SiraajBedford/Analogue-Power-Meter/README.md

# power meter

Machine
