SiraajBedford/Analogue-Power-Meter/Reports/Report 1/App-A.tex

     \chapter{Appendix A: Social contract}
     \vspace{-15mm}
     \begin{figure}[!htb]
     \centering
     	\fbox{}
       \label{fig:social_contract}
	\end{figure}
