SiraajBedford/Analogue-Power-Meter/Reports/Report 1/App-B.tex

     %\chapter{Appendix B: Wiring safety check}
    % \vspace{-15mm}
   %  \begin{figure}[!htb]
  %   \centering
 %    	\fbox{\includegraphics[width=0.75\linewidth]{./Figures/SafetyCheck.pdf}}
%	\label{fig:plugSafety}
%	\end{figure}

	     \chapter{Appendix B: Plug Safety Check}
     \vspace{-15mm}
     \begin{figure}[!htb]
     \centering
     	\fbox{}
       \label{fig:}
	\end{figure}
