SiraajBedford/Analogue-Power-Meter/Reports/Report 1/App-C.tex

 	     \chapter{Appendix C: GitHub Screengrab}
     \vspace{-15mm}
     \begin{figure}[!htb]
     \centering
     	\fbox{}
       \label{fig:}
	\end{figure}
