SiraajBedford/Analogue-Power-Meter/Reports/Report 1/Chapter6.tex

\chapter{System test results}

\begin{figure}[h]
    \centering
    
    \caption{Final system diagram}
    \label{fig:Final}
\end{figure}

The diagram in \ref{fig:Final} shows the complete system diagram for this stage of the power meter project.
The following outputs are available

\begin{itemize}
    \item The 12 V output from the switchmode regulator
    \item The +5 V output from the 5 V regulator
    \item The -5 V output from the charge pump scheme
\end{itemize}
