SiraajBedford/Analogue-Power-Meter/Reports/Report 2/App-A.tex

     \chapter{Appendix A: GitHub Activity Heatmap}

     \begin{figure}[H]
     \centering
     	\fbox{}
	\label{fig:github}
	\end{figure}
