SiraajBedford/Analogue-Power-Meter/Reports/Report 2/App-B.tex

     \chapter{Appendix B: Simulation Figures} 

\begin{figure}[H]
    \centering
    
    \caption{Nominal input and output with 1 volt change for $t>0.5s$}
    \label{fig:nomial_voltages}
\end{figure}

\begin{figure}[H]
    \centering
    
     \caption{Nominal input and output with 10 mA change for $t>0.5s$}
    \label{fig:nominal_current}
\end{figure}

\begin{figure}[H]
  \centering
  
    \caption{XOR AC output and Phase transducer output for a load impedance \\$Z=1000+j \cdot \omega \cdot 22\mu \  \Omega$ }
    \label{fig:phase22u}
\end{figure}

 \begin{figure}[H]
  \centering
  
    \caption{XOR AC output and Phase transducer output for a load impedance \\$Z=1000+j \cdot \omega \cdot 33\mu \  \Omega$ }
    \label{fig:phase33u}
\end{figure}
