SiraajBedford/Analogue-Power-Meter/Reports/Report 2/App-C.tex

\chapter{Appendix C: System Diagram}

\begin{figure}[H]
    \centering
   \fbox{} 
    \caption{System Diagram showing power supplies and op-amps used}
    \label{fig:system_diagram}
\end{figure}
