SiraajBedford/Analogue-Power-Meter/Reports/Report 2/App-D.tex

\chapter{Appendix D: System Test Diagrams}

\begin{figure}[H]
    \centering
    
    \caption{Switching noise on -5 VDC supply of charge pump output }
    \label{fig:-5V_noise}
\end{figure}

\begin{figure}[H]
    \centering
    
    \caption{Noise on LM7805 +5 VDC supply}
    \label{fig:+5V_noise}
\end{figure}

\begin{figure}[H]
    \centering
    
    \caption{Current consumption voltages on channel 1 and 2 for a bulky 100 $\Omega$ resistive load}
    \label{fig:system_current}
\end{figure}
