SiraajBedford/Analogue-Power-Meter/Reports/Report 3/App-A.tex

     \chapter{Appendix A: GitHub Activity Heatmap}

     \begin{figure}[!htb]
     \centering
     	\fbox{}
	\label{fig:github}
	\end{figure}
