SiraajBedford/Analogue-Power-Meter/Reports/Report 3/declaration.tex

\chapter{Declaration}

By submitting this report electronically, I declare that the entirety of the work contained
therein is my own, original work, that I am the sole author thereof (save to the extent
explicitly otherwise stated), that reproduction and publication thereof by Stellenbosch
University will not infringe any third party rights and that I have not previously in its
entirety or in part submitted it for obtaining any qualification.

\vspace{3cm}
\hspace{1.5cm}
\vspace{-.8cm}
\\
\noindent%
\parbox{.5\textwidth}{%
  Signature:\quad\dotfill\par
  \hfill S.\ Bedford\hspace{1.2cm}\null}

\vspace{1.5cm}
\hspace{2.7cm}
\vspace{-.5cm}
\\
\noindent%
\parbox{.5\textwidth}{%
  Date:\quad\dotfill\par}
