SiraajBedford/Analogue-Power-Meter/Reports/Report 1/nomenclature.tex

\chapter{Nomenclature}

\begin{Nomencl}
 \NomGroup{Constants}%-----------------------------------------------
   \item[$\mathrm{g} = $] $\mathrm{9.81\,m/s^2}$

 \NomGroup{Variables}%-----------------------------------------------
   \item[$P$]
                      \UnitLine{Power}{W}

\end{Nomencl}

\endinput
