SiraajBedford/Analogue-Power-Meter/Reports/Report 2/nomenclature.tex

\chapter{Nomenclature}

\begin{Nomencl}

 \NomGroup{List Of Constants}%-----------------------------------------------
  \item[$V_T=26$]
                   \UnitLine{Thermal Voltage}{mV}
 \NomGroup{List Of Variables}%-----------------------------------------------

   \item[$V_{pp}$]
                      \UnitLine{Peak-to-peak Voltage}{V_{p-p}}
   \item[$V_{peak}$]
                      \UnitLine{Peak Voltage}{V_{peak}}
   \item[$\tau$]
                      \UnitLine{Time Constant}{s}
   \item[$Z$]
                      \UnitLine{Impedance}{\Omega}

    \NomGroup{List of Abbreviations}
   \item[AC]        Alternating Current
   \item[DC]        Direct Current
   \item[RMS]      Root Mean Square  
   \item[op-amp] Operational Amplifier
   \item[ADC] Analog-to-Digital Converter
   \item[pp] peak-to-peak   
   \item[p] peak   
   \item[KVL] Kirchoff's Voltage Law
     \item[KCL] Kirchoff's Current Law
    \item[LPF] Low Pass Filter
    \item[XOR] Exclusive OR gate
    \item[PWM] Pulse Width Modulated
    
    \NomGroup{List of Units}
   \item[F] Farad
   \item[$\Omega$] Ohm
    \item[\si{\ampere}] Ampere
    \item[\si{\volt}] Volt

\end{Nomencl}

\endinput
