SiraajBedford/Analogue-Power-Meter/LTSpice/Demo 2/Voltage Peak detector/VarDesigns.asc

C1: cap; 100n
C2: cap; 100n
C3: cap; 100n
C4: cap; 100n
D1: diode; 1N4007
D2: diode; 1N4007
D3: diode; 1N4007
D4: diode; 1N4007
D5: diode; 1N4007
D6: diode; 1N4007
R1: res; 20k
R2: res
U1: opamp2; TLC2272
U2: opamp2; TLC2272
U3: opamp2; TLC2272
U4: opamp2; TLC2272
U5: opamp2; TLC2272
U6: opamp2; TLC2272
U7: opamp2; TLC2272
Named nets: 0, +5V_LM7805
