SiraajBedford/Analogue-Power-Meter/LTSpice/Demo 3/Switch with overcurrent protection/V_Designs.asc

U1: opamp2; TL081
U2: opamp2; TL081
V1: voltage; 1.4
Named nets: +5V_78, 0
