SiraajBedford/Analogue-Power-Meter/LTSpice/Final/21093741.asc

C2: cap; 150µ
C3: cap; 122µ
C4: cap; 122µ
C5: cap; 0.33µ
C6: cap; 0.1µ
C7: cap; 10µ
C8: cap; 100µ
C16: cap; 1n
C17: cap; 100n
C18: cap; 30µ
Cff1: cap; 3.7n
D3: diode
D4: schottky; 1N5822
D5: diode; 1N4148
D6: diode; 1N4148
D7: zener; 1N750
D13: diode; 1N4148
D14: diode; 1N4148
D15: diode; 1N4148
D16: diode; 1N4148
L1: ind; 68µ
LOAD2: res; 100
Q4: npn; 2N3904
Q5: npn; 2N3904
Q6: npn; 2N3904
Q7: npn; 2N3904
Q8: npn; 2N3904
Q9: npn; 2N3904
R15: res; 1k
R16: res; 8.2k
R17: res; 1k
R18: res; 1k
R19: res; 1k
R20: res; 3.9k
R21: res; 33
R22: res; 100k
R23: res; 100k
R24: res; 1.5Meg
R25: res; 100k
R26: res; 10k
R27: res; 10k
R28: res; 1k
R29: res; 1k
R30: res; 10k
R31: res; 10k
R32: res; 1k
R33: res; 1.2k
R34: res; 150k
R35: res; 1k
R36: res; 2.2k
R37: res; 1k
R38: res; 20k
R39: res; 7000
R40: res; 10k
R41: res; 5.8
R_Sense2: res; 30m
U8: LM2595_ADJ_TRANS
U9: LM7805
U10: opamp2; TLC2272
U11: MOC3020
U12: opamp2; TLC2272
U13: opamp2; TLC2272
U14: opamp2; TLC2272
U15: opamp2; TLC2272
U16: opamp2; TLC2272
U17: opamp2; TLC2272
U18: opamp2; TLC2272
U19: XOR_2
U20: opamp2; TLC2272
U21: opamp2; TLC2272
U22: opamp2; TLC2272
V2: voltage; PULSE(0 5 0 0 0 50u 100u)
V8: voltage; 0
V9: voltage; 0
V10: voltage; -5
V11: voltage; 5
V12: voltage; 5
V13: voltage; 3
V14: voltage; PULSE(0 5 0 0 0 1 2)
V_source_RMS1: voltage; SINE(0 30.8 50)
Named nets: 0, -5V_charge_pump, +12V_switchmode, +5V_LM7805, Rectifier_Ouput, +5V_78, -5V_CP, XOR_out, XOR_in1, XOR_in2, V_mains, V_mains_TRIAC_result, V_LED_+, S, Current_REF
.inc MOC302x.lib
.inc BT134.lib
.inc 2N3904.lib
.tran 0 2 0 1
.inc TL081.lib
.inc TLC2272.lib
.inc LM78XX_RS.lib
.inc XOR_2.asy
.inc DigitalLogic.lib
.inc 1N400.lib
.inc ST_POWER_SCHOTTKY_V6.LIB
