SiraajBedford/Analogue-Power-Meter/LTSpice/Demo 1/Charge pump/ChargeP.asc

C1: cap; 10µ
C2: cap; 100µ
D1: diode; 1N4148
D2: diode; 1N4148
D3: zener; 1N750
Q1: npn; 2N3904
Q2: npn; 2N3904
Q3: npn; 2N3904
R1: res; 1k
R2: res; 1k
R3: res; 1k
R4: res; 3.9k
R5: res; 33
V1: voltage; PULSE(0 5 0 0 0 50u 100u)
V2: voltage; 12
Named nets: 0, -5V
.inc 2N3904.lib
.tran 0 70m 0 0.1
50% duty cycle from arduino PWM
12V From switchmode regulator
