SiraajBedford/Analogue-Power-Meter/LTSpice/Demo 1/Combination of Sub circuits/Final.asc

C1: cap; 0.33µ
C2: cap; 0.1µ
C3: cap; 10µ
C4: cap; 100µ
C5: cap; 150µ
C6: cap; 122µ
C7: cap; 122µ
Cff: cap; 3.7n
D1: diode; 1N4148
D2: diode; 1N4148
D3: diode
D4: schottky; 1N5822
D5: zener; 1N750
L1: ind; 68µ
Q1: npn; 2N3904
Q2: npn; 2N3904
Q3: npn; 2N3904
R1: res; 1k
R2: res; 1k
R3: res; 1k
R4: res; 1k
R5: res; 8.2k
R6: res; 3.9k
R8: res; 33
U1: LM7805
U2: LM2595_ADJ_TRANS
V1: voltage; PULSE(0 5 0 0 0 50u 100u)
V2: voltage; 0
V3: voltage; 0
V_source_RMS1: voltage; SINE(0 30.8 50)
Named nets: 0, -5V_charge_pump, +12V_switchmode, +5V_LM7805, Rectifier_Ouput
.tran 0 0.5 0 0.1
.inc LM2595_ADJ_TRANS.LIB
.inc ST_POWER_SCHOTTKY_V6.LIB
.inc 2N3904.lib
.inc LM78XX_RS.lib
