SiraajBedford/Analogue-Power-Meter/LTSpice/Demo 1/Combination of Sub circuits/Rep3.asc

C1: cap; 10µ
C2: cap; 100µ
C3: cap; 0.33µ
C4: cap; 0.1µ
C5: cap; 150µ
C6: cap; 122µ
C7: cap; 122µ
Cff1: cap; 3.3n
D1: diode; 1N4148
D2: diode; 1N4148
D3: zener; 1N750
D4: diode
D5: schottky; 1N5822
L1: ind; 68µ
Q1: npn; 2N3904
Q2: npn; 2N3904
Q3: npn; 2N3904
R1: res; 1k
R2: res; 1k
R3: res; 1k
R4: res; 3.9k
R5: res; 33
R6: res; 100
R7: res; 1k
R8: res; 8.2k
U1: LM7805
U2: LM2595_ADJ_TRANS
V1: voltage; PULSE(0 5 0 0 0 50u 100u)
V2: voltage; 12
V3: voltage; 12
V_peak1: voltage; SINE(0 22.4 50)
Named nets: 0, -5V, V_out, 12V
.inc 2N3904.lib
50% duty cycle from arduino PWM
12V From switchmode regulator
.inc LM78XX_RS.lib
.inc LM2595_ADJ_TRANS.LIB
.inc ST_POWER_SCHOTTKY_V6.LIB
.tran 0 1 0 1
