SiraajBedford/Analogue-Power-Meter/LTSpice/Demo 1/Linear/linear.asc

C1: cap; 0.33µ
C2: cap; 0.1µ
R1: res; 100
U2: LM7805
V1: voltage; 12
Named nets: 0, V_out
.inc LM78XX_RS.lib
.tran 0 1 0 0.1
