SiraajBedford/Analogue-Power-Meter/LTSpice/Demo 1/Rectifier/rectifier.asc

C1: cap; 150µ
D1: diode
R1: res; 100
V_peak: voltage; SINE(0 30.8 50)
Named nets: 0, V_out
.tran 0 0.15 0 1
