SiraajBedford/Analogue-Power-Meter/LTSpice/Demo 1/Switchmode/Switchmode.asc

C1: cap; 122µ
C3: cap; 122µ
Cff: cap; 3.3n
D2: schottky; 1N5822
L1: ind; 68µ
R1: res; 1k
R2: res; 8.2k
U1: LM2595_ADJ_TRANS
Vpp: voltage; 32
Named nets: 0, 12V
.inc LM2595_ADJ_TRANS.LIB
.inc ST_POWER_SCHOTTKY_V6.LIB
.tran 0 10m 0 1
