SiraajBedford/Analogue-Power-Meter/LTSpice/Demo 2/Current Peak detector/CurrentSensing.asc

C2: cap; 100n
D1: diode; 1N4148
D3: diode; 1N4148
I1: current; PWL(0 0 0.5 0 0.51 10m 1 10m)
LOAD: res; 154
R1: res; 20k
R2: res; 2.2k
R3: res; 150k
R4: res; 1k
R5: res; 1k
R_Sense: res; 30m
U1: opamp2; TLC2272
U2: opamp2; TLC2272
U3: opamp2; TLC2272
U4: opamp2; TLC2272
V1: voltage; -5
V2: voltage; 5
V3: voltage; SINE(0 30.8 50)
Named nets: 0, +5V_78, -5V_CP, Nominal_Output
.inc TL081.lib
.inc TLC2272.LIB
.tran 0 1 0 1
