SiraajBedford/Analogue-Power-Meter/LTSpice/Demo 2/Final Circuit/Demo_2_Final.asc

C1: cap; 0.33µ
C2: cap; 0.1µ
C3: cap; 10µ
C4: cap; 100µ
C5: cap; 150µ
C6: cap; 122µ
C7: cap; 122µ
C8: cap; 1n
C9: cap; 100n
C10: cap; 30µ
Cff: cap; 3.7n
D1: diode; 1N4148
D2: diode; 1N4148
D3: diode
D4: schottky; 1N5822
D5: zener; 1N750
D6: diode; 1N4148
D7: diode; 1N4148
D8: diode; 1N4148
D9: diode; 1N4148
L1: ind; 68µ
LOAD1: res; 100
Q1: npn; 2N3904
Q2: npn; 2N3904
Q3: npn; 2N3904
R1: res; 1k
R2: res; 1k
R3: res; 1k
R4: res; 1k
R5: res; 8.2k
R6: res; 3.9k
R7: res; 150k
R8: res; 33
R9: res; 1k
R10: res; 2.2k
R11: res; 10k
R12: res; 1k
R13: res; 1.2k
R14: res; 1k
R15: res; 20k
R16: res; 7000
R20: res; 1.5Meg
R21: res; 100k
R_Sense1: res; 30m
U1: LM7805
U2: LM2595_ADJ_TRANS
U3: opamp2; TLC2272
U4: opamp2; TLC2272
U5: opamp2; TLC2272
U6: opamp2; TLC2272
U7: opamp2; TLC2272
U8: opamp2; TLC2272
U9: opamp2; TLC2272
U10: XOR_2
U11: opamp2; TLC2272
U12: opamp2; TLC2272
V1: voltage; PULSE(0 5 0 0 0 50u 100u)
V_source_RMS1: voltage; SINE(0 30.8 50)
Named nets: 0, +12V_switchmode, +5V_78, -5V_CP, To_current_peak_detector, XOR_out, XOR_in1, XOR_in2
.tran 0 5 0 5
.inc LM2595_ADJ_TRANS.LIB
.inc ST_POWER_SCHOTTKY_V6.LIB
.inc 2N3904.lib
.inc TL081.lib
.inc TLC2272.LIB
.inc LM78XX_RS.lib
.inc 1N400.lib
.inc DigitalLogic.lib
