SiraajBedford/Analogue-Power-Meter/LTSpice/Demo 2/Phase Shift Detector/PhaseShiftXOR.asc

C1: cap; 55µ
C2: cap; 33µ
D1: diode; 1N4148
D2: diode; 1N4148
LOAD1: res; 1k
R1: res; 6.8k
R2: res; 150k
R3: res; 1k
R4: res; 1k
R5: res; 5.6k
R_Sense1: res; 30m
U1: XOR_2
U2: opamp2; TLC2272
U3: opamp2; TLC2272
U4: opamp2; TLC2272
U5: opamp2; TLC2272
V1: voltage; SINE(0 30.8 50)
V2: voltage; -5
V3: voltage; 5
V4: voltage; SINE(0 2 50 0 0 0)
Named nets: XOR_out, XOR_in1, XOR_in2, 0, +5V_78, -5V_CP, Phase_Shift_Voltage, Voltage_in, Current_in
.inc DigitalLogic.lib
.tran 0 2.5 0 1
.inc TL081.lib
.inc TLC2272.lib
