SiraajBedford/Analogue-Power-Meter/LTSpice/Demo 2/Voltage Peak detector/Voltage shifter and peak detector.asc

C1: cap; 1n
D1: diode; 1N4148
D3: diode; 1N4148
R1: res; 1.5Meg
R2: res; 100k
R3: res; 1k
R4: res; 1.2k
R5: res; 10k
U1: opamp2; TLC2272
U2: opamp2; TLC2272
U3: opamp2; TLC2272
V1: voltage; SINE(0 30.8 50)
V2: voltage; 5
V3: voltage; -5
V4: voltage; PWL(0 0 0.5 0 0.51 1 1 1)
Named nets: 0, +5V_78, -5V_CP, Nominal_Output, Step, Nominal_Input
.inc TL081.lib
.inc TLC2272.LIB
.tran 0 1 0 1
.inc 1N400.lib
