SiraajBedford/Analogue-Power-Meter/LTSpice/Demo 3/Current Sensing with switch/Dems.asc

LOAD1: res; 100
Q1: npn; 2N3904
Q2: npn; 2N3904
Q3: npn; 2N3904
R6: res; 100k
R7: res; 100k
R8: res; 10k
R9: res; 10k
R10: res; 1k
R11: res; 1k
R12: res; 10k
R13: res; 10k
R14: res; 5.8
R_Sense1: res; 30m
U5: opamp2; TLC2272
U6: MOC3020
U7: opamp2; TLC2272
V1: voltage; PWL(0 0 0.25 1 2 5)
V3: voltage; -5
V4: voltage; SINE(0 30.8 50)
V5: voltage; 5
V6: voltage; 5
V7: voltage; 3
Named nets: 0, -5V_CP, +5V_78, R_comparing_200mA, V_mains, V_mains_TRIAC_result, Current_REF, V_LED_+, S_beetle, Q_trip, Ramp
.inc MOC302x.lib
.inc 2N3904.lib
.tran 0 2 0 1
.inc TLC2272.lib
