SiraajBedford/Analogue-Power-Meter/LTSpice/Demo 3/Current Sensing with switch/Latch.asc

Q1: npn; 2N3904
Q2: npn; 2N3904
R1: res; 100k
R2: res; 100k
R3: res; 10k
R4: res; 10k
R5: res; 1k
R6: res; 1k
R7: res; 10k
R8: res; 10k
V1: voltage; 5
Named nets: 0, +5V_78, R_comparing_200mA, S
