SiraajBedford/Analogue-Power-Meter/LTSpice/Demo 3/Current Sensing with switch/OC.asc

LOAD1: res; 1k
Q1: npn; 2N3904
Q2: npn; 2N3904
Q3: npn; 2N3904
R1: res; 100k
R2: res; 100k
R3: res; 10k
R4: res; 10k
R5: res; 1k
R6: res; 1k
R7: res; 10k
R8: res; 10k
R9: res; 5.8
R_Sense1: res; 30m
U1: opamp2; TLC2272
U2: MOC3020
U3: opamp2; TLC2272
V1: voltage; SINE(0 30.8 50)
V2: voltage; 5
V3: voltage; -5
V4: voltage; 5
V5: voltage; 3
V6: voltage; PWL(0 0 1 2.5 2 5)
Named nets: 0, +5V_78, R_comparing_200mA, V_mains, V_mains_TRIAC_result, V_LED_+, S, -5V_CP, Current_REF, Q, Ramp
.inc MOC302x.lib
.inc BT134.lib
.inc 2N3904.lib
.tran 0 4 0 1
.inc TLC2272.lib
