SiraajBedford/Analogue-Power-Meter/LTSpice/Demo 3/Switch with overcurrent protection/Switch.asc

Q1: npn; 2N3904
Q2: npn; 2N3904
Q3: npn; 2N3904
R2: res; 100k
R3: res; 100k
R4: res; 10k
R5: res; 10k
R6: res; 1k
R7: res; 1k
R8: res; 10k
R9: res; 10k
R10: res; 3.3
R_LOAD: res; 100
U1: MOC3020
U2: opamp2; TLC2272
U4: opamp2; TLC2272
V1: voltage; SINE(0 30.8 50)
V2: voltage; 5
V3: voltage; 5
V5: voltage; 3.25
V6: voltage; 3.7
Named nets: 0, +5V_78, S_beetle_reset_pin, R_comparing_200mA, V_before_buffer, V_mains, V_mains_TRIAC_result, Current_Transducer_Output_for_200mA, Compare_for_200mA, V_LED_+
.inc MOC302x.lib
.inc BT134.lib
.inc 2N3904.lib
.tran 0 1 0 1
.inc TL081.lib
.inc TLC2272.lib
