SiraajBedford/Analogue-Power-Meter/(list of files, drawings)

Other design files:
LTSpice/Demo 1/Switchmode/ST_POWER_SCHOTTKY_V6.OLB
